m-chenie/chaotic-tarot-reader/RaspberryPi_source/cards/02.png

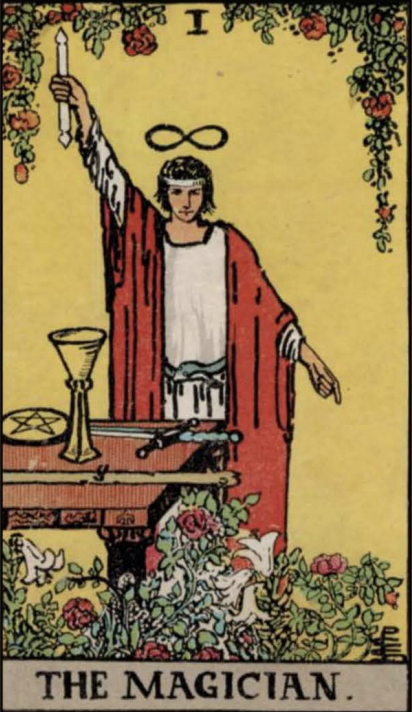
RaspberryPi_source/cards/02.png
