m-chenie/chaotic-tarot-reader/RaspberryPi_source/cards/03.png

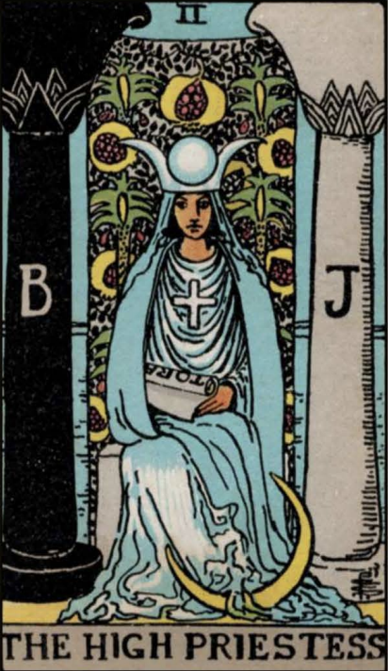
RaspberryPi_source/cards/03.png
