m-chenie/chaotic-tarot-reader/RaspberryPi_source/cards/04.png

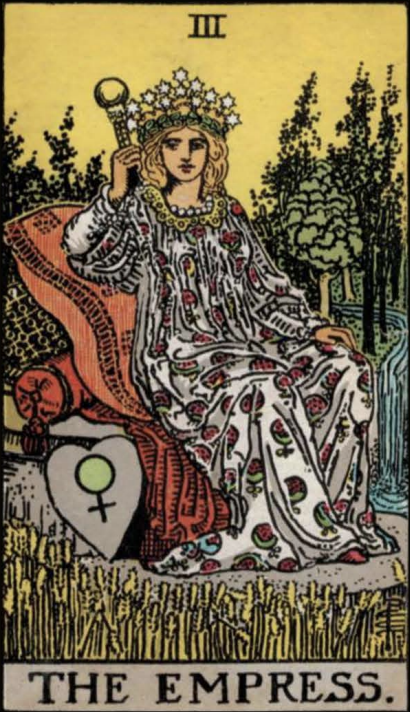
RaspberryPi_source/cards/04.png
