m-chenie/chaotic-tarot-reader/RaspberryPi_source/cards/05.png

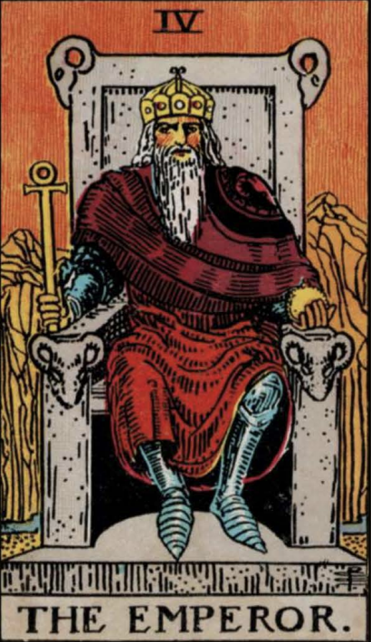
RaspberryPi_source/cards/05.png
