m-chenie/chaotic-tarot-reader/RaspberryPi_source/cards/06.png

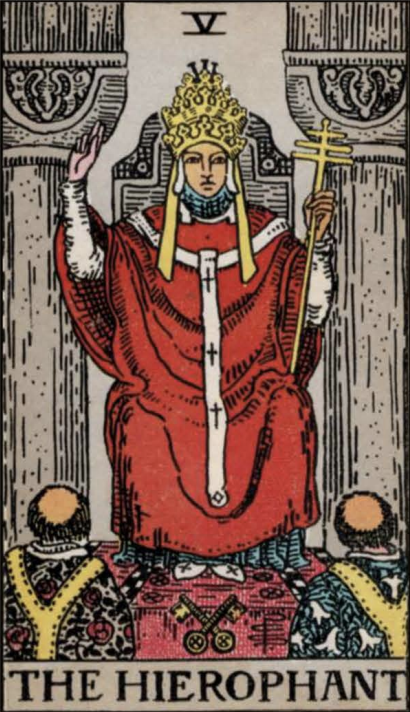
RaspberryPi_source/cards/06.png
