m-chenie/chaotic-tarot-reader/RaspberryPi_source/cards/07.png

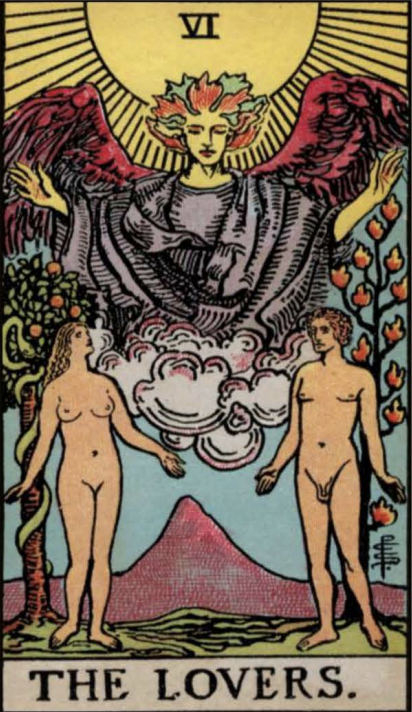
RaspberryPi_source/cards/07.png
