m-chenie/chaotic-tarot-reader/RaspberryPi_source/cards/08.png

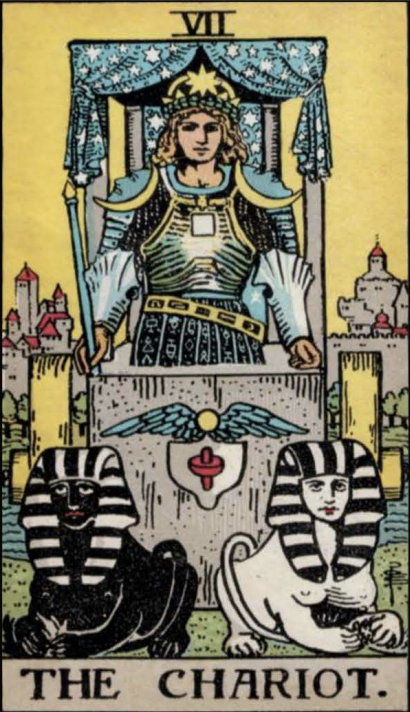
RaspberryPi_source/cards/08.png
