m-chenie/chaotic-tarot-reader/RaspberryPi_source/cards/09.png

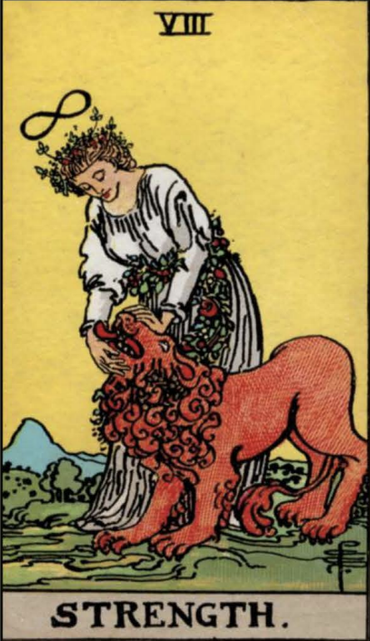
RaspberryPi_source/cards/09.png
