m-chenie/chaotic-tarot-reader/RaspberryPi_source/cards/10.png

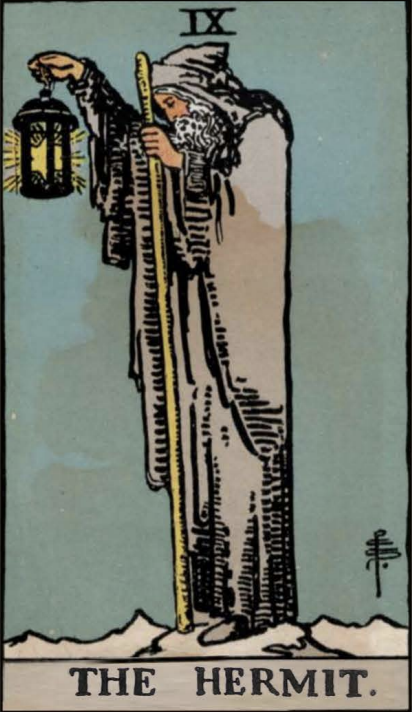
RaspberryPi_source/cards/10.png
