m-chenie/chaotic-tarot-reader/RaspberryPi_source/cards/11.png

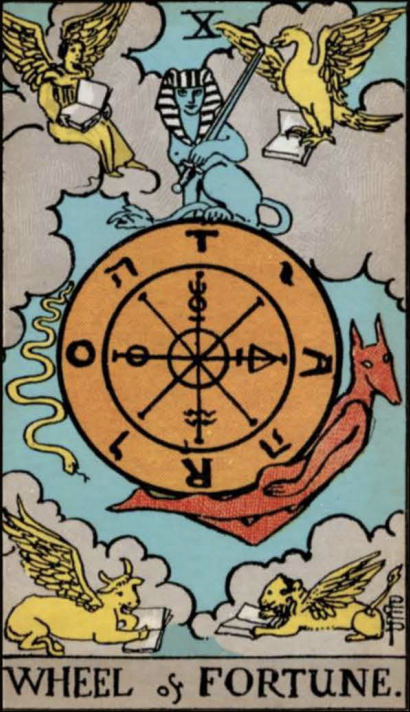
RaspberryPi_source/cards/11.png
