m-chenie/chaotic-tarot-reader/RaspberryPi_source/cards/12.png

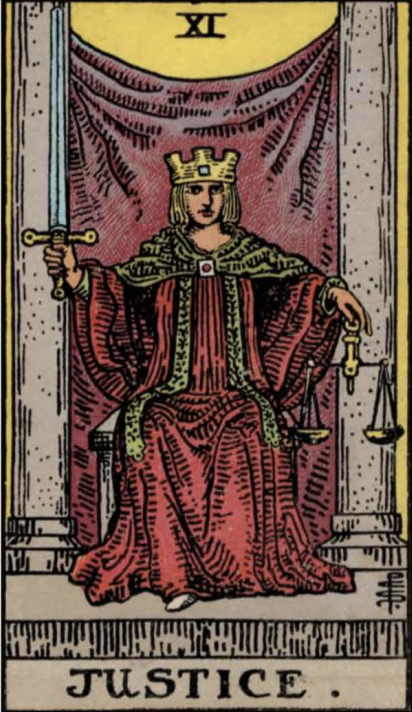
RaspberryPi_source/cards/12.png
