m-chenie/chaotic-tarot-reader/RaspberryPi_source/cards/13.png

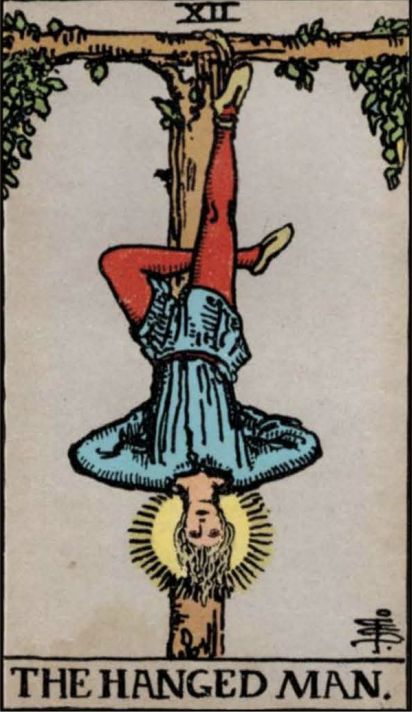
RaspberryPi_source/cards/13.png
