m-chenie/chaotic-tarot-reader/RaspberryPi_source/cards/14.png

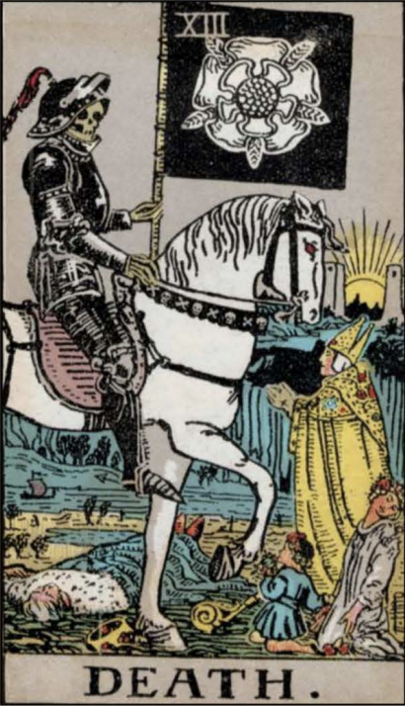
RaspberryPi_source/cards/14.png
