m-chenie/chaotic-tarot-reader/RaspberryPi_source/cards/15.png

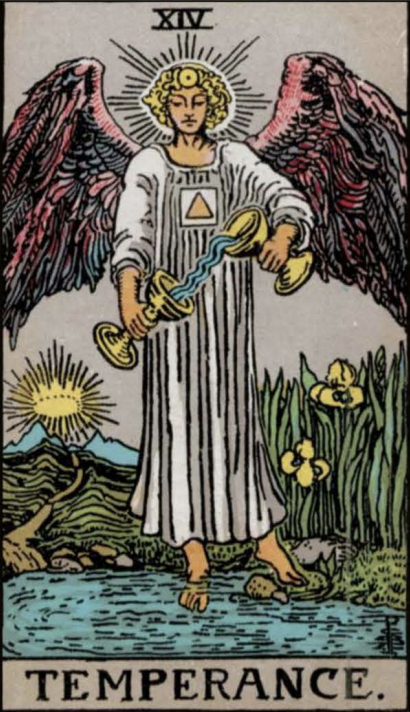
RaspberryPi_source/cards/15.png
