m-chenie/chaotic-tarot-reader/RaspberryPi_source/cards/16.png

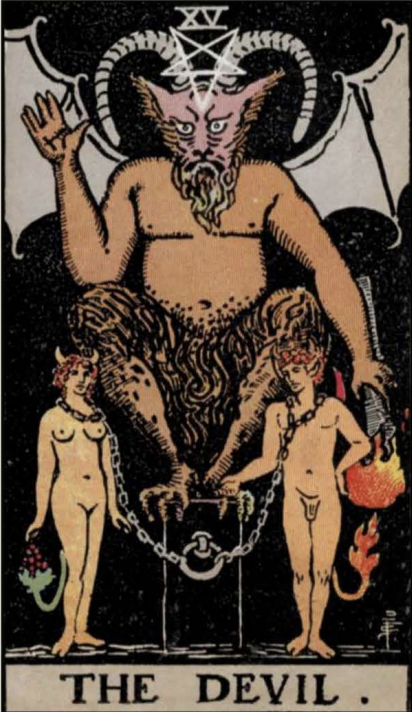
RaspberryPi_source/cards/16.png
