m-chenie/chaotic-tarot-reader/RaspberryPi_source/cards/17.png

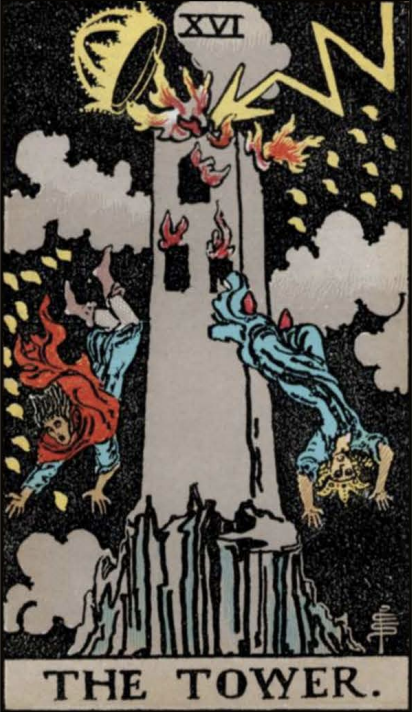
RaspberryPi_source/cards/17.png
