m-chenie/chaotic-tarot-reader/RaspberryPi_source/cards/18.png

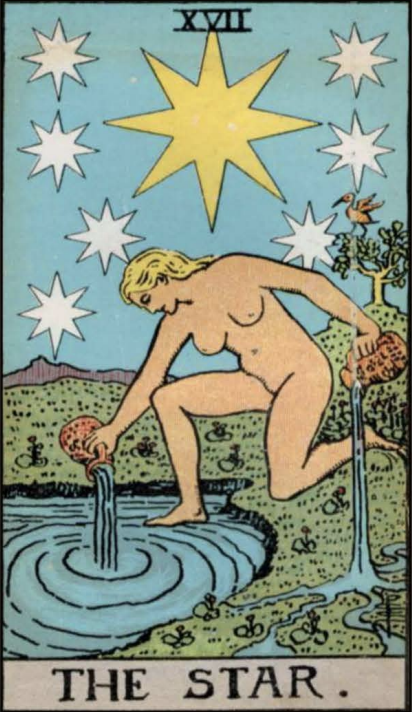
RaspberryPi_source/cards/18.png
