m-chenie/chaotic-tarot-reader/RaspberryPi_source/cards/19.png

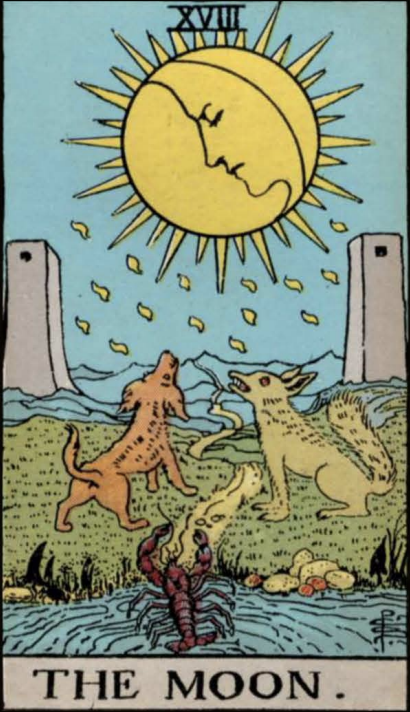
RaspberryPi_source/cards/19.png
