m-chenie/chaotic-tarot-reader/RaspberryPi_source/cards/20.png

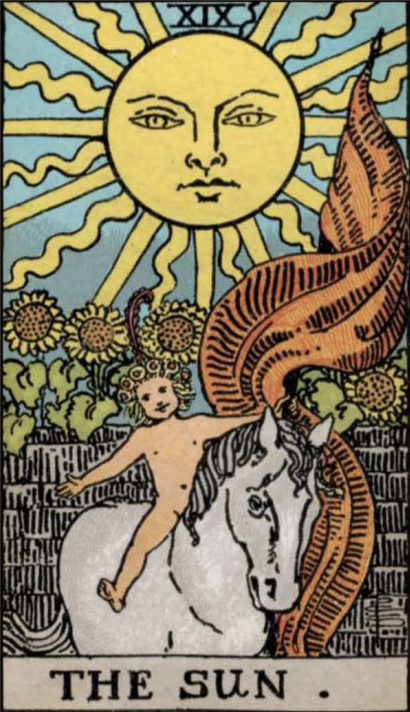
RaspberryPi_source/cards/20.png
