m-chenie/chaotic-tarot-reader/RaspberryPi_source/cards/21.png

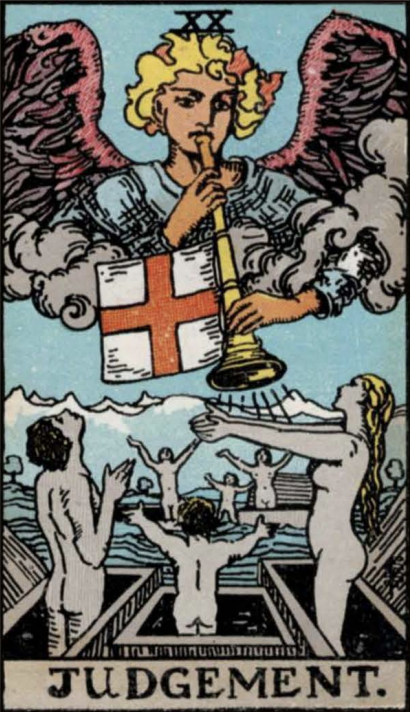
RaspberryPi_source/cards/21.png
