m-chenie/chaotic-tarot-reader/RaspberryPi_source/cards/22.png

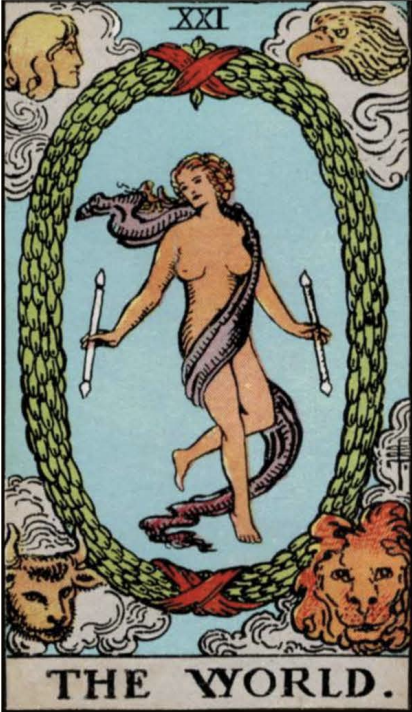
RaspberryPi_source/cards/22.png
