m-chenie/chaotic-tarot-reader/RaspberryPi_source/cards/23.png

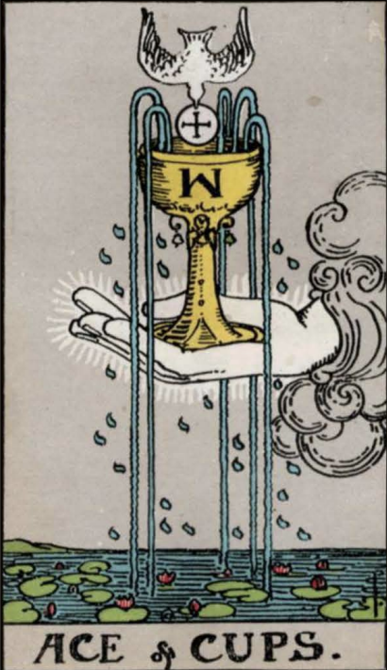
RaspberryPi_source/cards/23.png
