m-chenie/chaotic-tarot-reader/RaspberryPi_source/cards/24.png

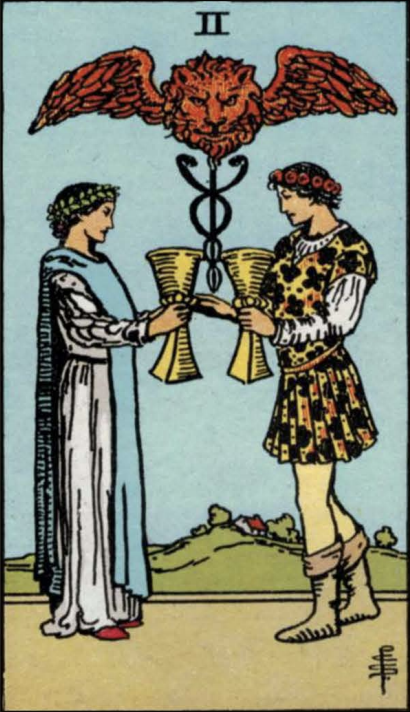
RaspberryPi_source/cards/24.png
