m-chenie/chaotic-tarot-reader/RaspberryPi_source/cards/25.png

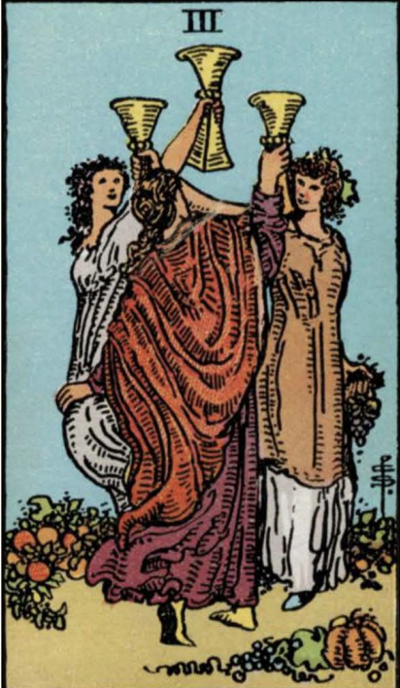
RaspberryPi_source/cards/25.png
