m-chenie/chaotic-tarot-reader/RaspberryPi_source/cards/26.png

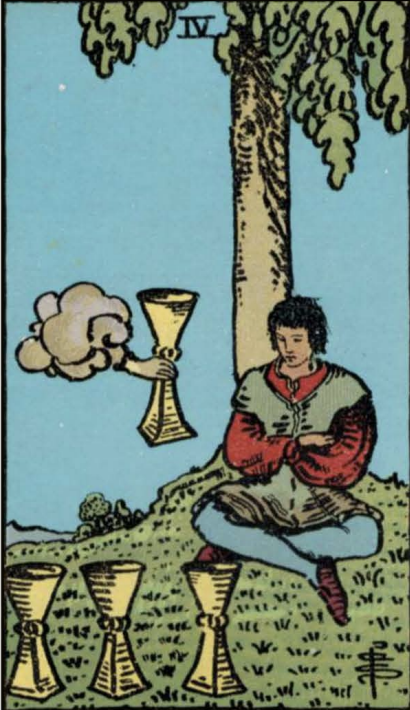
RaspberryPi_source/cards/26.png
