m-chenie/chaotic-tarot-reader/RaspberryPi_source/cards/27.png

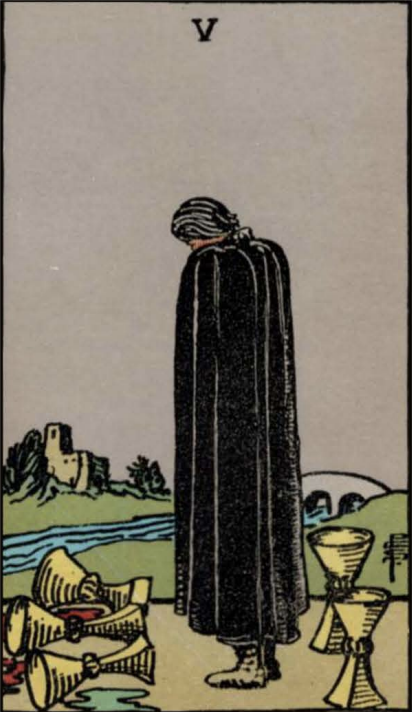
RaspberryPi_source/cards/27.png
