m-chenie/chaotic-tarot-reader/RaspberryPi_source/cards/28.png

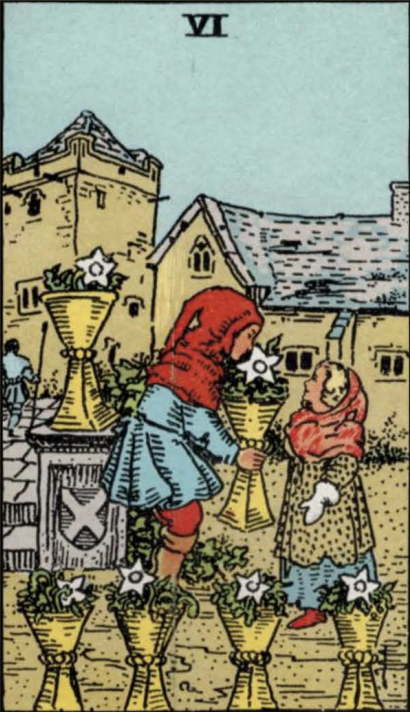
RaspberryPi_source/cards/28.png
