m-chenie/chaotic-tarot-reader/RaspberryPi_source/cards/29.png

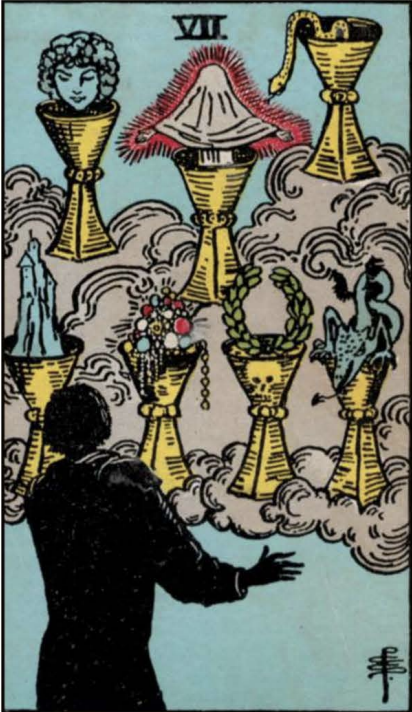
RaspberryPi_source/cards/29.png
