m-chenie/chaotic-tarot-reader/RaspberryPi_source/cards/30.png

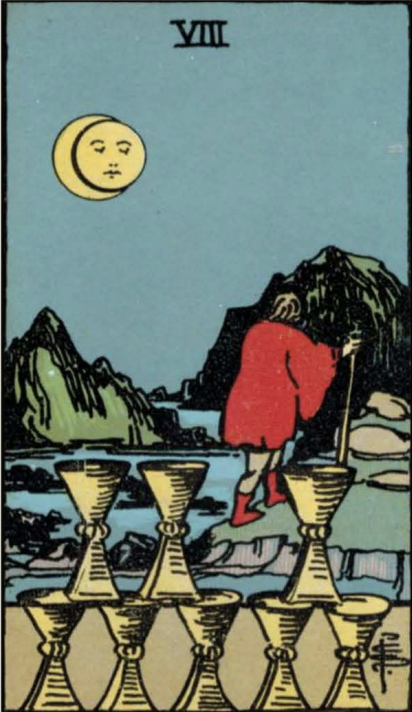
RaspberryPi_source/cards/30.png
