m-chenie/chaotic-tarot-reader/RaspberryPi_source/cards/31.png

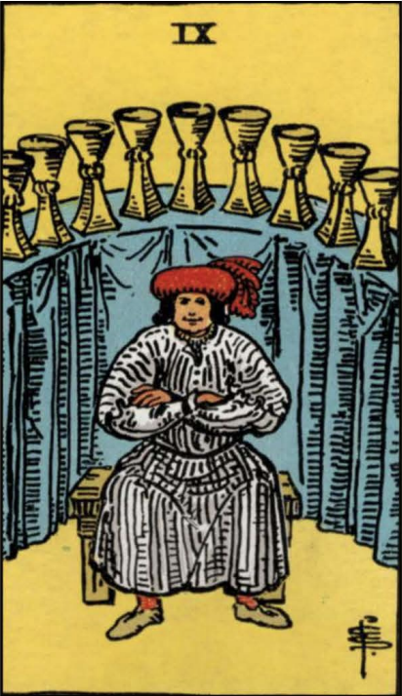
RaspberryPi_source/cards/31.png
