m-chenie/chaotic-tarot-reader/RaspberryPi_source/cards/32.png

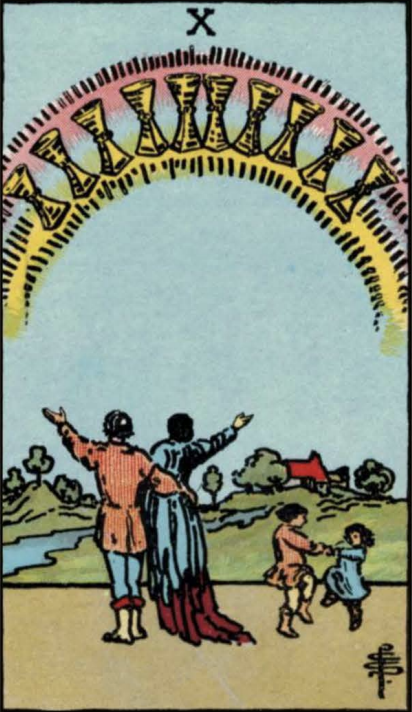
RaspberryPi_source/cards/32.png
