m-chenie/chaotic-tarot-reader/RaspberryPi_source/cards/33.png

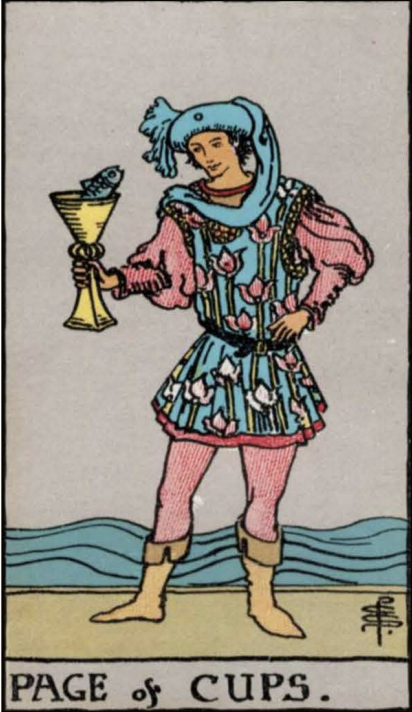
RaspberryPi_source/cards/33.png
