m-chenie/chaotic-tarot-reader/RaspberryPi_source/cards/34.png

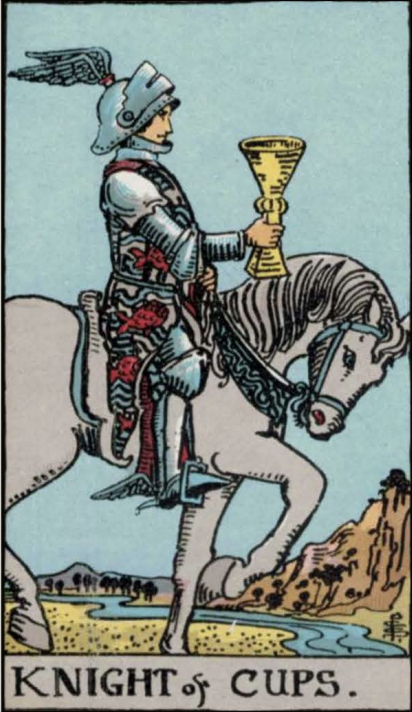
RaspberryPi_source/cards/34.png
