m-chenie/chaotic-tarot-reader/RaspberryPi_source/cards/35.png

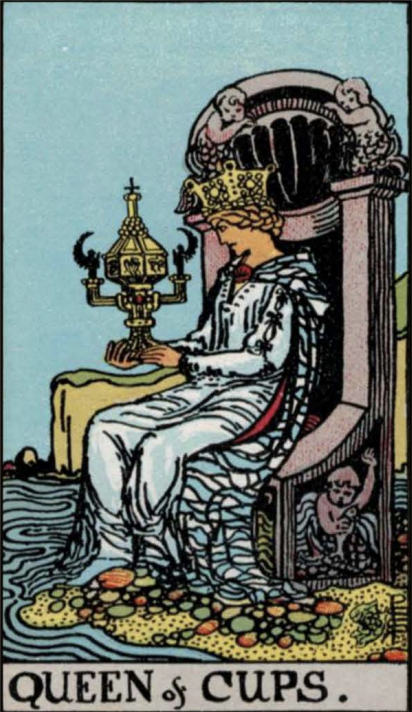
RaspberryPi_source/cards/35.png
