m-chenie/chaotic-tarot-reader/RaspberryPi_source/cards/36.png

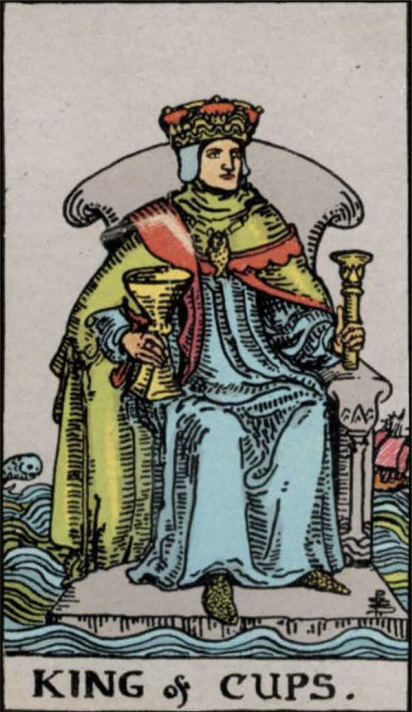
RaspberryPi_source/cards/36.png
