m-chenie/chaotic-tarot-reader/RaspberryPi_source/cards/37.png

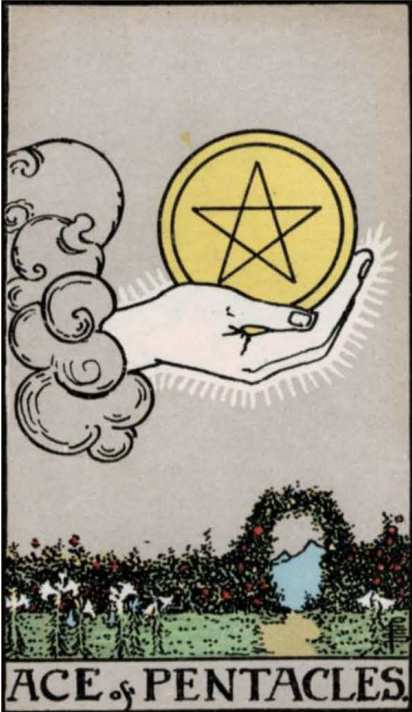
RaspberryPi_source/cards/37.png
