m-chenie/chaotic-tarot-reader/RaspberryPi_source/cards/38.png

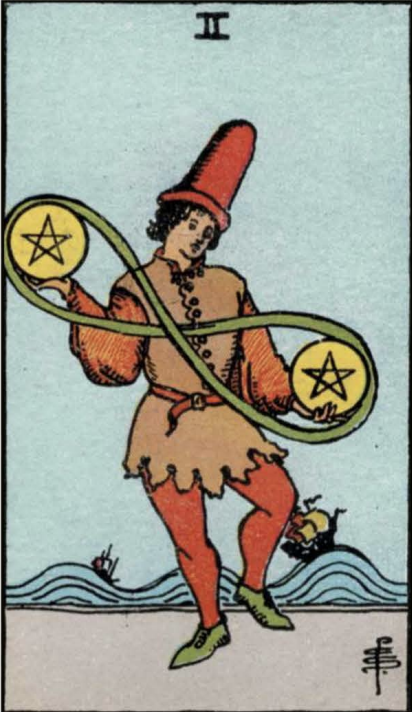
RaspberryPi_source/cards/38.png
