m-chenie/chaotic-tarot-reader/RaspberryPi_source/cards/39.png

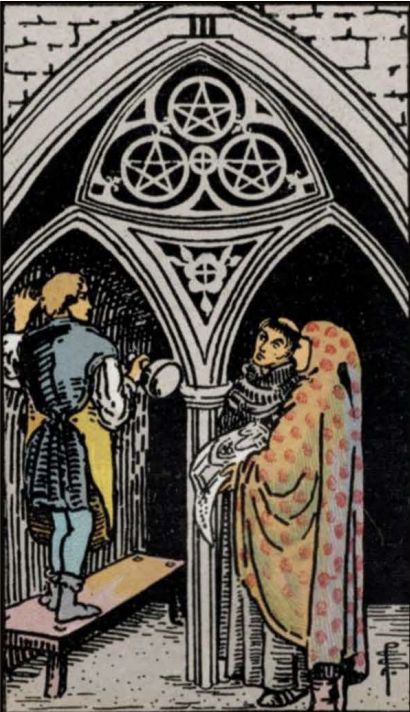
RaspberryPi_source/cards/39.png
