m-chenie/chaotic-tarot-reader/RaspberryPi_source/cards/40.png

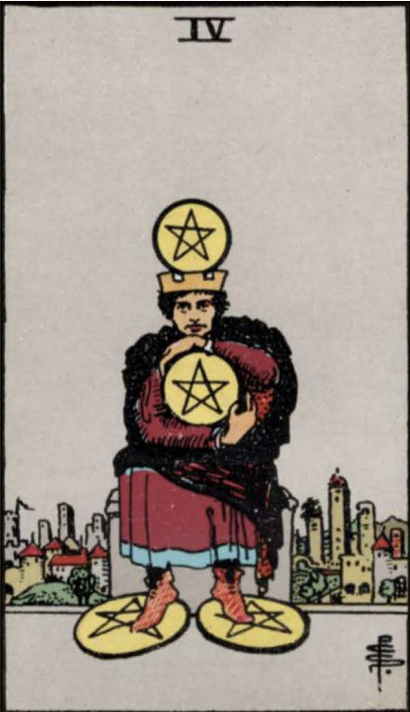
RaspberryPi_source/cards/40.png
