m-chenie/chaotic-tarot-reader/RaspberryPi_source/cards/41.png

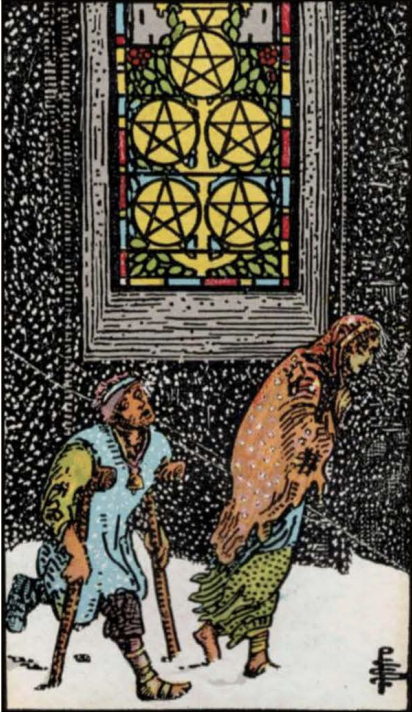
RaspberryPi_source/cards/41.png
