m-chenie/chaotic-tarot-reader/RaspberryPi_source/cards/42.png

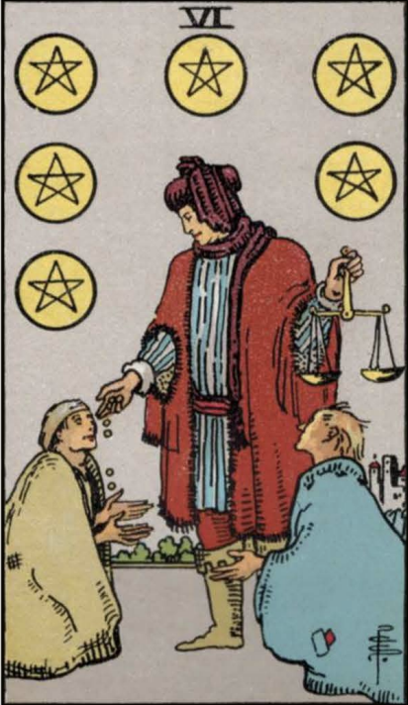
RaspberryPi_source/cards/42.png
