m-chenie/chaotic-tarot-reader/RaspberryPi_source/cards/43.png

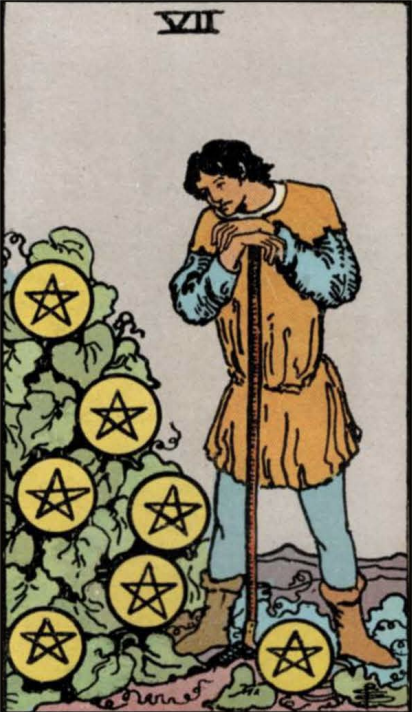
RaspberryPi_source/cards/43.png
