m-chenie/chaotic-tarot-reader/RaspberryPi_source/cards/44.png

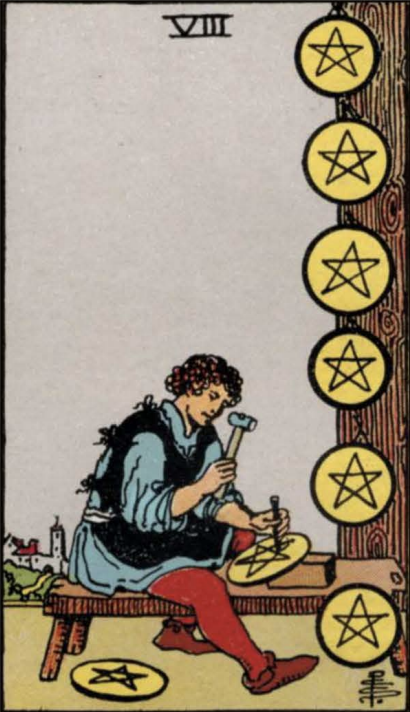
RaspberryPi_source/cards/44.png
