m-chenie/chaotic-tarot-reader/RaspberryPi_source/cards/45.png

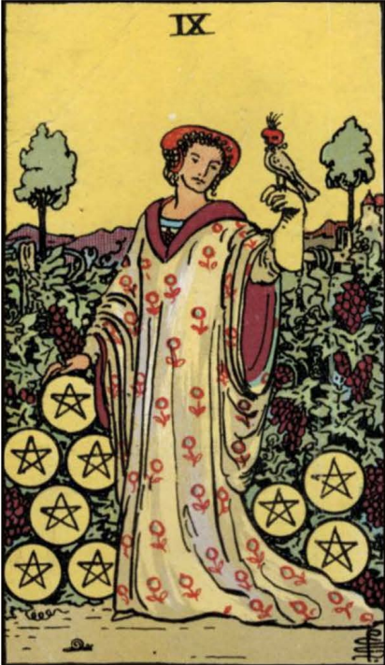
RaspberryPi_source/cards/45.png
