m-chenie/chaotic-tarot-reader/RaspberryPi_source/cards/46.png

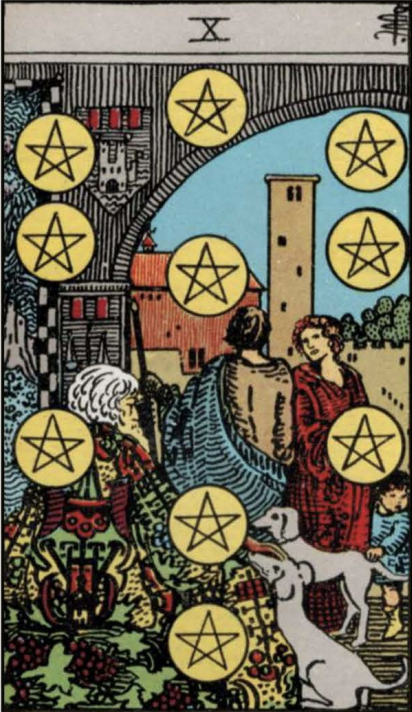
RaspberryPi_source/cards/46.png
