m-chenie/chaotic-tarot-reader/RaspberryPi_source/cards/47.png

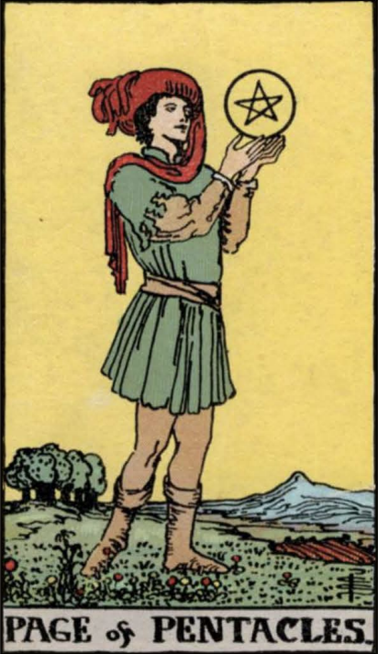
RaspberryPi_source/cards/47.png
