m-chenie/chaotic-tarot-reader/RaspberryPi_source/cards/48.png

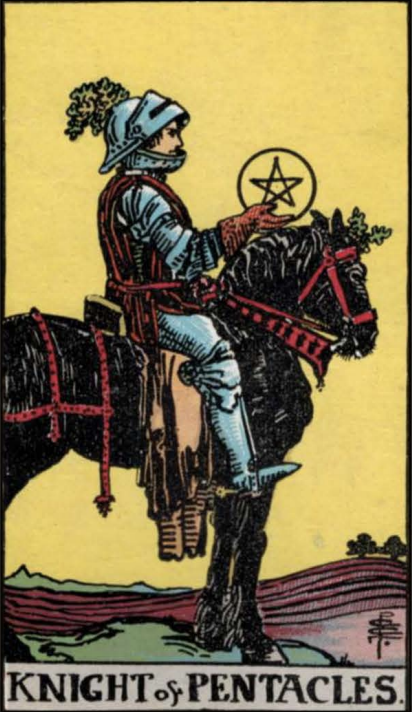
RaspberryPi_source/cards/48.png
