m-chenie/chaotic-tarot-reader/RaspberryPi_source/cards/49.png

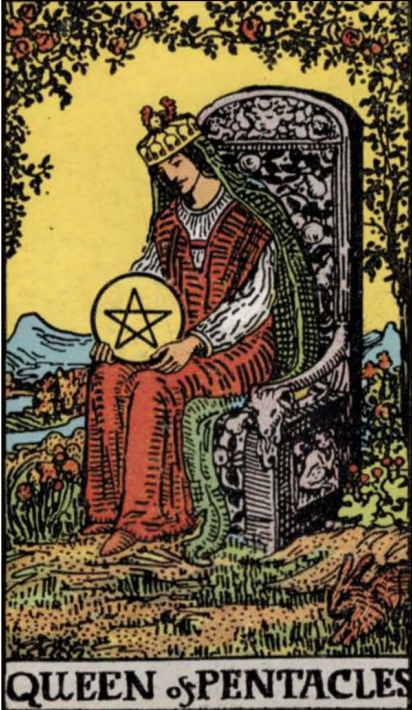
RaspberryPi_source/cards/49.png
