m-chenie/chaotic-tarot-reader/RaspberryPi_source/cards/50.png

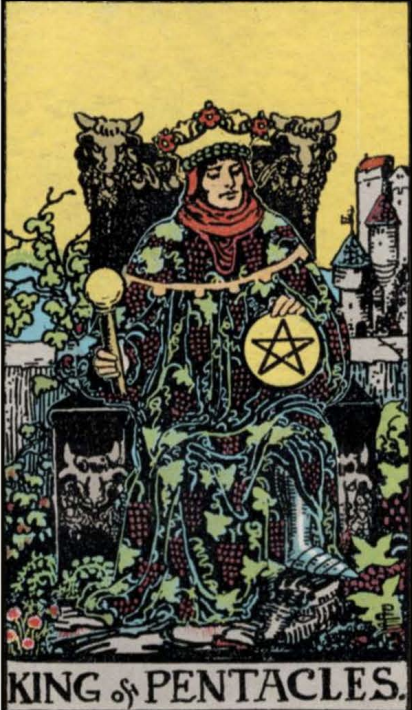
RaspberryPi_source/cards/50.png
