m-chenie/chaotic-tarot-reader/RaspberryPi_source/cards/51.png

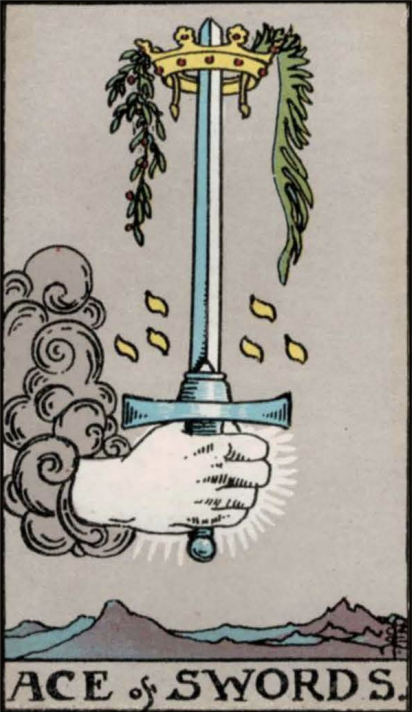
RaspberryPi_source/cards/51.png
