m-chenie/chaotic-tarot-reader/RaspberryPi_source/cards/52.png

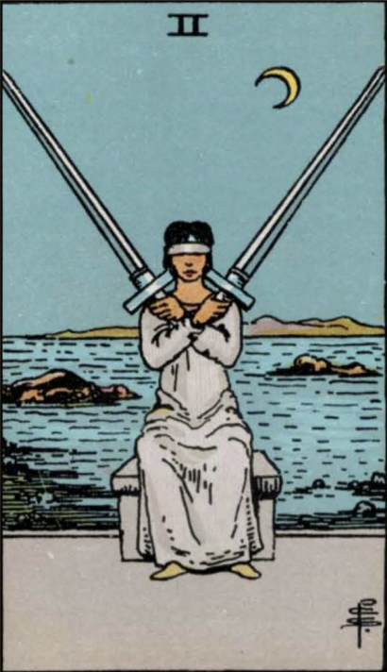
RaspberryPi_source/cards/52.png
