m-chenie/chaotic-tarot-reader/RaspberryPi_source/cards/53.png

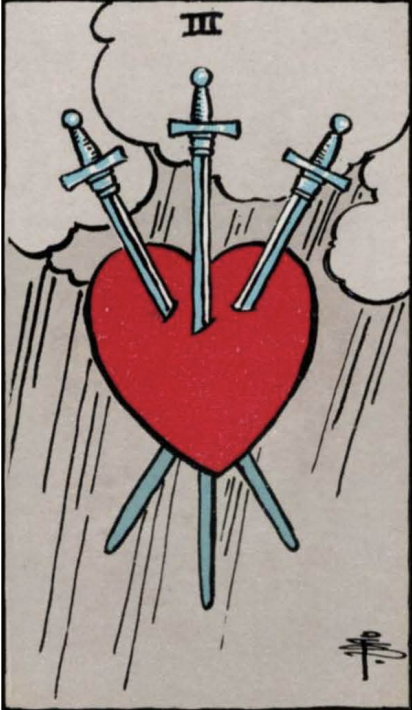
RaspberryPi_source/cards/53.png
