m-chenie/chaotic-tarot-reader/RaspberryPi_source/cards/54.png

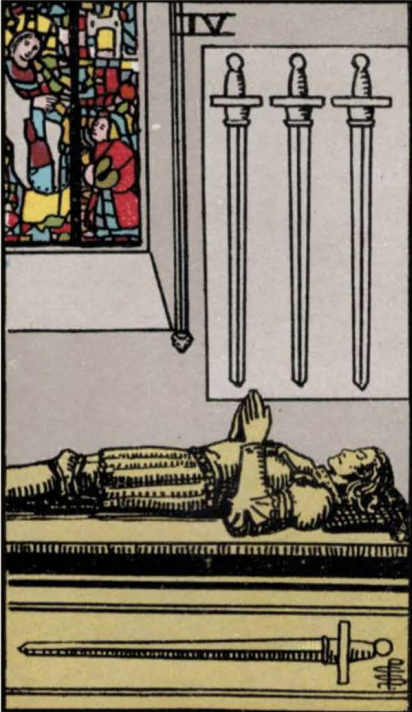
RaspberryPi_source/cards/54.png
