m-chenie/chaotic-tarot-reader/RaspberryPi_source/cards/55.png

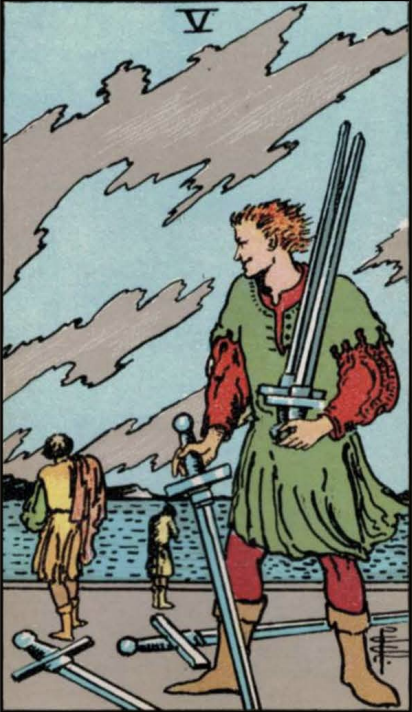
RaspberryPi_source/cards/55.png
