m-chenie/chaotic-tarot-reader/RaspberryPi_source/cards/56.png

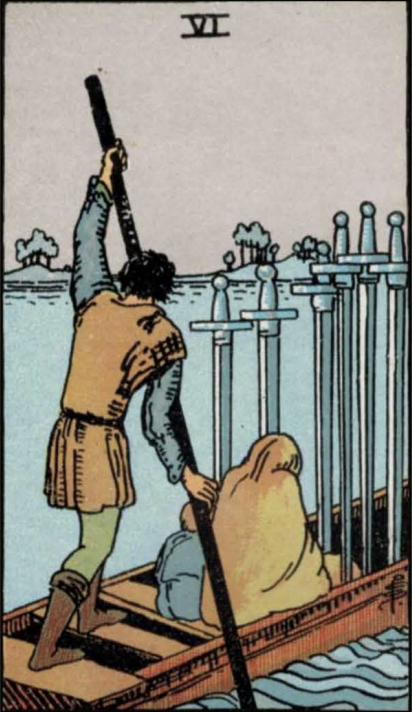
RaspberryPi_source/cards/56.png
