m-chenie/chaotic-tarot-reader/RaspberryPi_source/cards/57.png

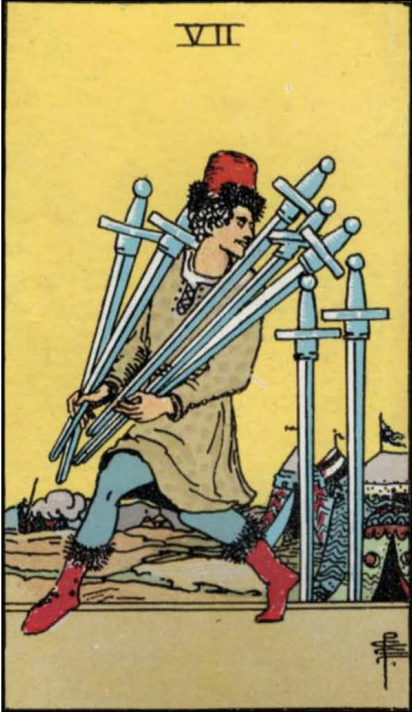
RaspberryPi_source/cards/57.png
