m-chenie/chaotic-tarot-reader/RaspberryPi_source/cards/58.png

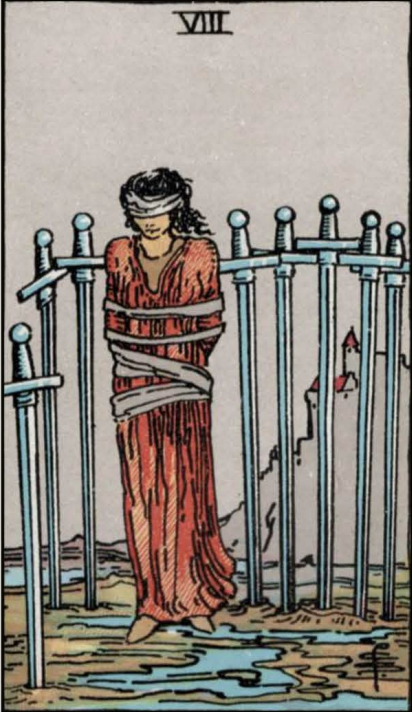
RaspberryPi_source/cards/58.png
