m-chenie/chaotic-tarot-reader/RaspberryPi_source/cards/59.png

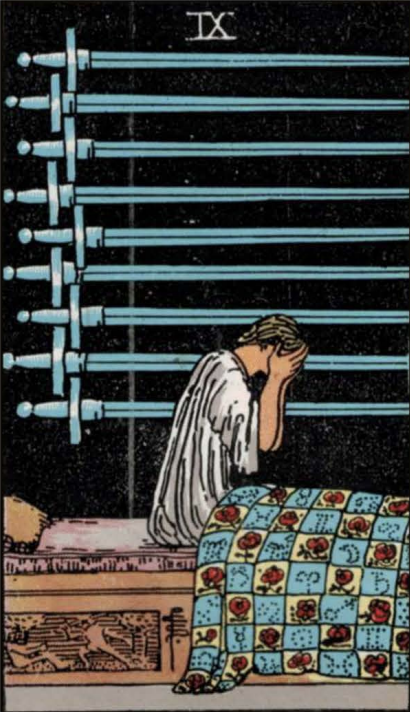
RaspberryPi_source/cards/59.png
