m-chenie/chaotic-tarot-reader/RaspberryPi_source/cards/60.png

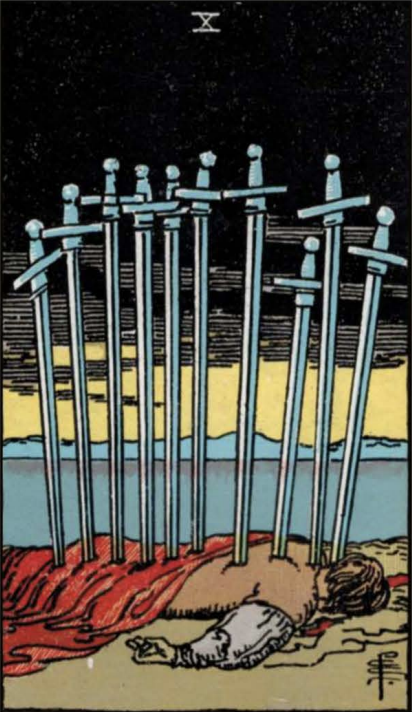
RaspberryPi_source/cards/60.png
