m-chenie/chaotic-tarot-reader/RaspberryPi_source/cards/61.png

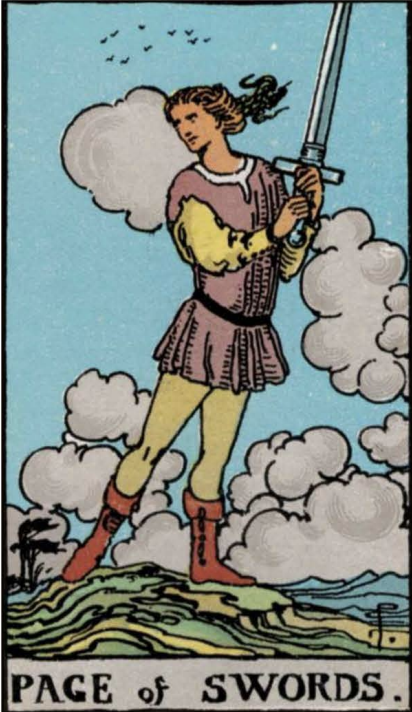
RaspberryPi_source/cards/61.png
