m-chenie/chaotic-tarot-reader/RaspberryPi_source/cards/62.png

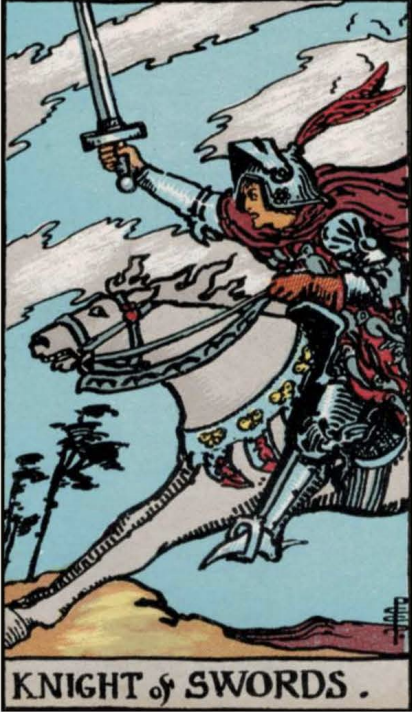
RaspberryPi_source/cards/62.png
