m-chenie/chaotic-tarot-reader/RaspberryPi_source/cards/63.png

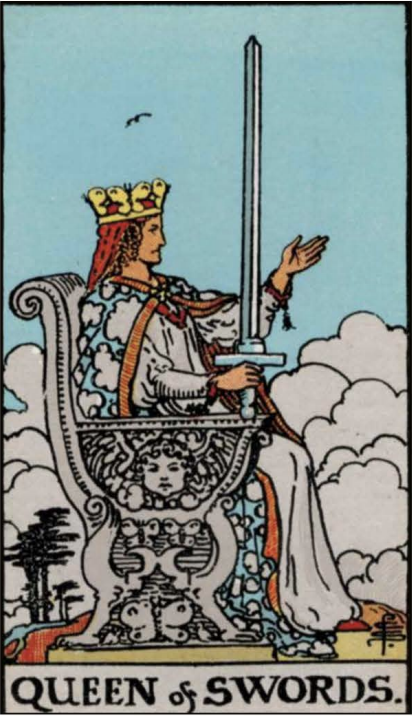
RaspberryPi_source/cards/63.png
