m-chenie/chaotic-tarot-reader/RaspberryPi_source/cards/64.png

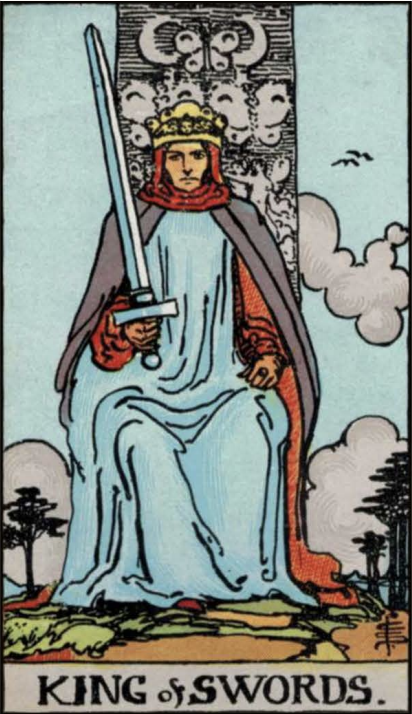
RaspberryPi_source/cards/64.png
