m-chenie/chaotic-tarot-reader/RaspberryPi_source/cards/65.png

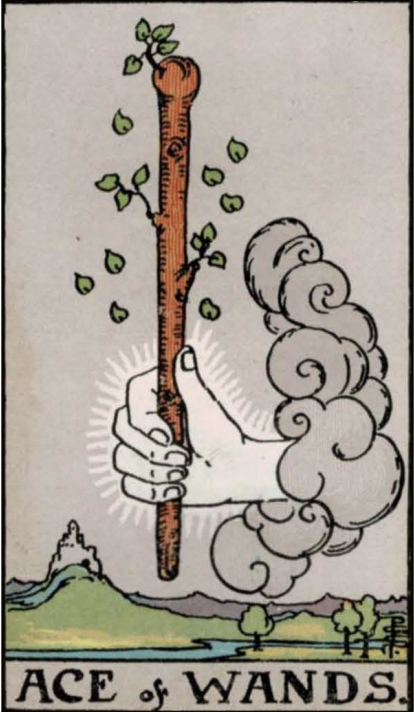
RaspberryPi_source/cards/65.png
