m-chenie/chaotic-tarot-reader/RaspberryPi_source/cards/66.png

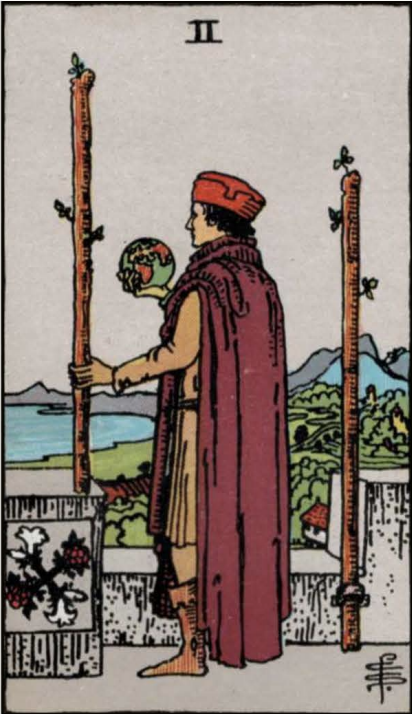
RaspberryPi_source/cards/66.png
