m-chenie/chaotic-tarot-reader/RaspberryPi_source/cards/67.png

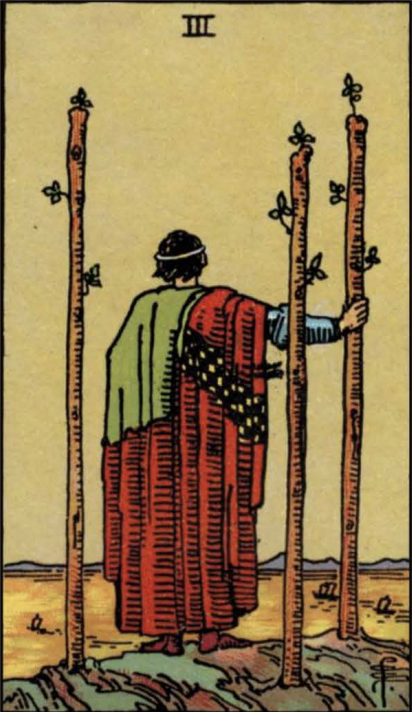
RaspberryPi_source/cards/67.png
