m-chenie/chaotic-tarot-reader/RaspberryPi_source/cards/68.png

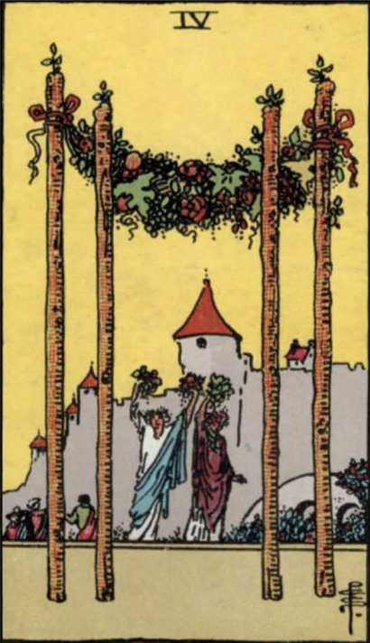
RaspberryPi_source/cards/68.png
