m-chenie/chaotic-tarot-reader/RaspberryPi_source/cards/69.png

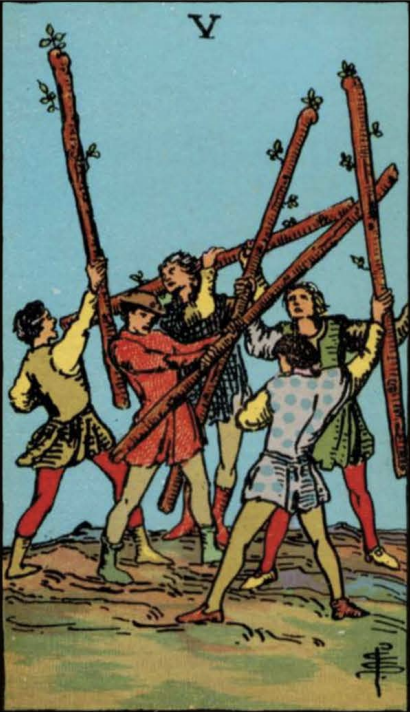
RaspberryPi_source/cards/69.png
