m-chenie/chaotic-tarot-reader/RaspberryPi_source/cards/70.png

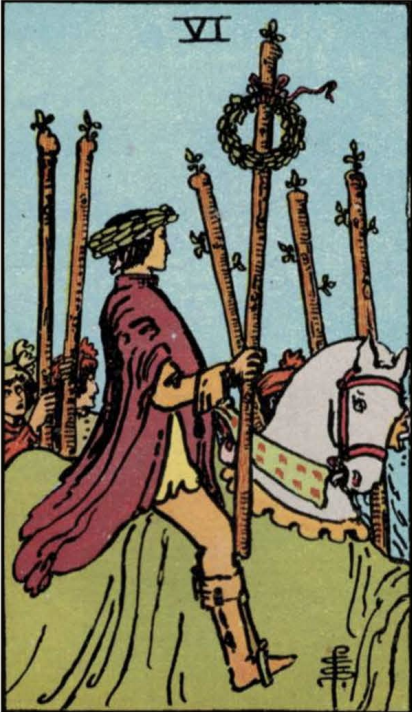
RaspberryPi_source/cards/70.png
