m-chenie/chaotic-tarot-reader/RaspberryPi_source/cards/71.png

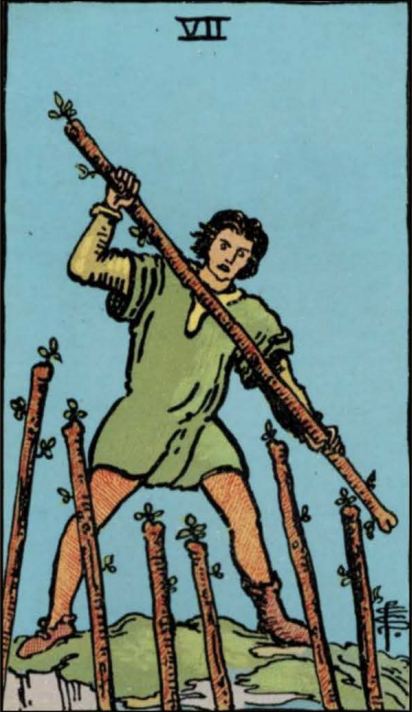
RaspberryPi_source/cards/71.png
