m-chenie/chaotic-tarot-reader/RaspberryPi_source/cards/72.png

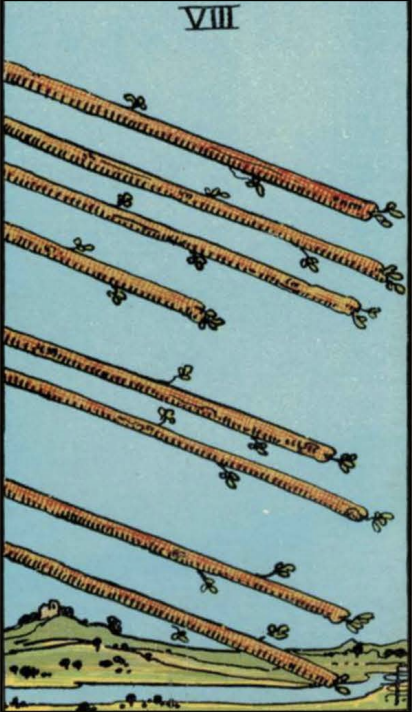
RaspberryPi_source/cards/72.png
