m-chenie/chaotic-tarot-reader/RaspberryPi_source/cards/73.png

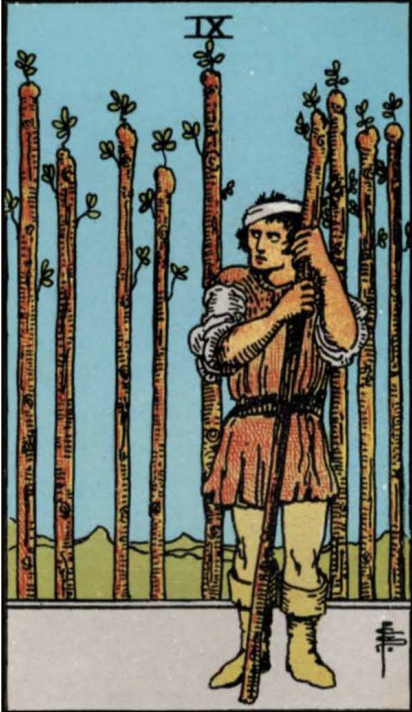
RaspberryPi_source/cards/73.png
