m-chenie/chaotic-tarot-reader/RaspberryPi_source/cards/74.png

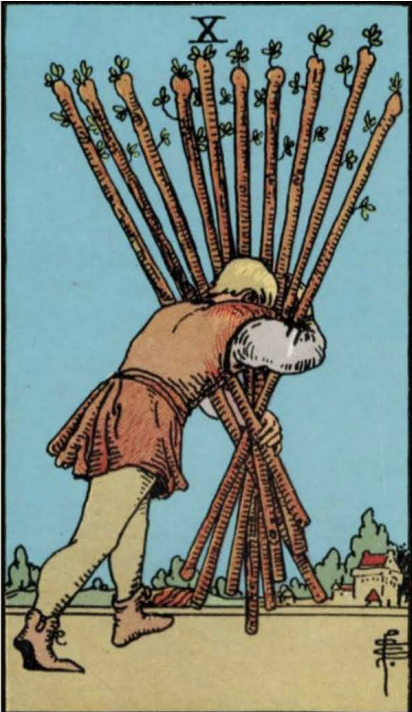
RaspberryPi_source/cards/74.png
