m-chenie/chaotic-tarot-reader/RaspberryPi_source/cards/75.png

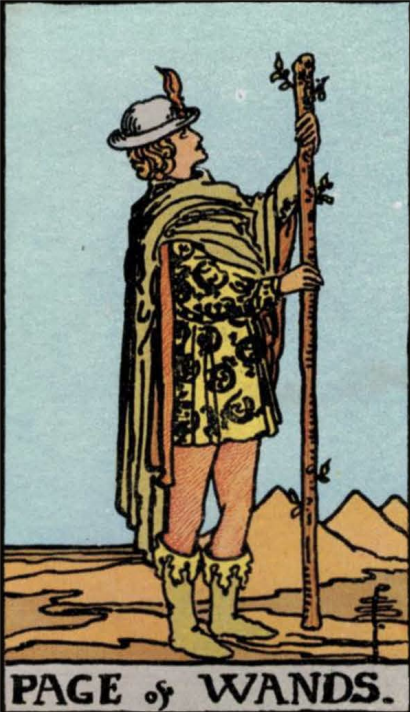
RaspberryPi_source/cards/75.png
