m-chenie/chaotic-tarot-reader/RaspberryPi_source/cards/76.png

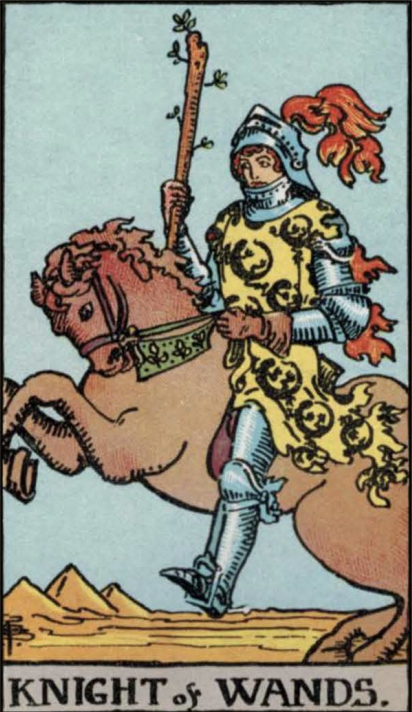
RaspberryPi_source/cards/76.png
