m-chenie/chaotic-tarot-reader/RaspberryPi_source/cards/77.png

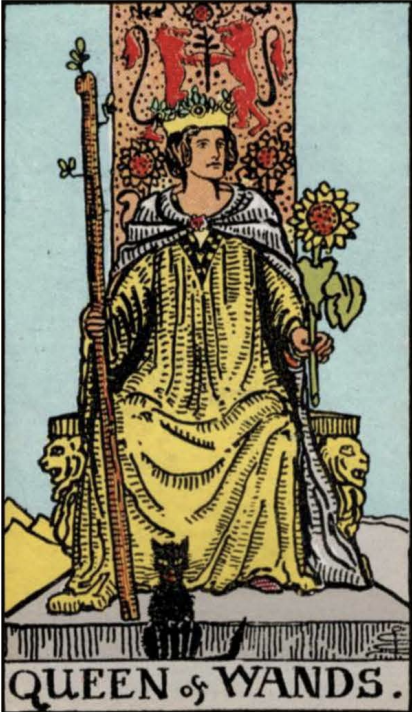
RaspberryPi_source/cards/77.png
