m-chenie/chaotic-tarot-reader/RaspberryPi_source/cards/78.png

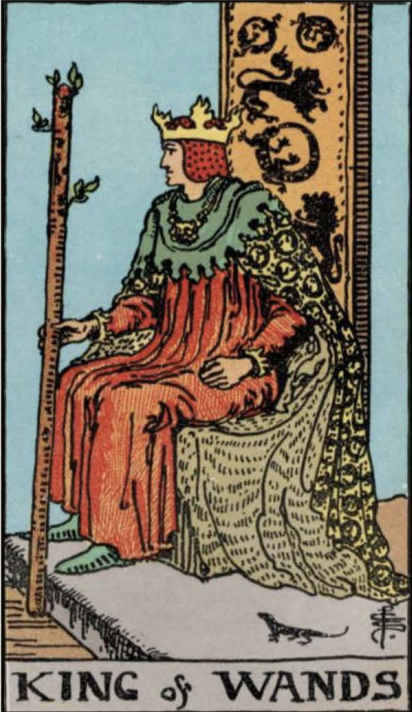
RaspberryPi_source/cards/78.png
