m-chenie/chaotic-tarot-reader/(commit log)

2025-04-10 fixed henon map issues, y is accumulated in 64 bit signed register and is right now
    [henon_map_q31.v, henon_prng_tb.v, henon_prng_top.v]
2025-04-24 added arduino code
2025-04-24 Added folder for raspberry pi required files
    1. background image
    2. tarot card image
    3. tarot_gui_final.py
2025-04-24 Added folder for raspberry pi required files
2025-04-25 added BOM
    [BOM.csv]
2025-04-26 Update README.md
    Updated the readme file to include a link to the cad file as it is big to be uploaded to Github, > 25MB size file.
2025-04-26 Add files via upload
    **3D Model Access**
    The enclosure for the Chaotic Tarot Reader, referred to as the DSL Box, was developed using Autodesk Fusion 360 to securely and efficiently house the system’s hardware components. The 3D model can be accessed via the following link: https://a360.co/4jVf0f3
    🔗 View the DSL Box 3D Model
    The design features dedicated compartments for the fingerprint sensor, LCD display, and supporting electronics, ensuring a compact and organized assembly.
    Users can interact with the model through the embedded viewer, allowing rotation, zooming, and detailed inspection in a 3D environment.
    The model is also available for download, enabling further modifi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
2025-04-26 DSL_CAD_file/DSL_Box.stl
    The model is also available for download, enabling further mo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
